Miguelmoral/ESP8266-energy-monitor/README.md

# ESP8266-energy-monitor

## Flashear firmware en la placa NodeMCU
Utilizar arduino IDE añadiendo la placa ESP8266 agregando en el gestor de URLs adicionales de tarjetas la [URL](http://arduino.esp8266.com/stable/package_esp8266com_index.json) 

## Aprovisionamiento servidor

- Descargar los archivos del repositorio:

 ` sudo git clone https://github.com/Miguelmoral/ESP8266-energy-monitor`

- Instalar requirements:

 ` cd ESP8266-energy-monitor `

  `sudo make install `

## Iniciar aplicación web

` make ejecutar `
