Miguelmoral/ESP8266-energy-monitor/documentación/portada/portada.tex

\begin{titlepage}

\newlength{\centeroffset}
\setlength{\centeroffset}{-0.5\oddsidemargin}
\addtolength{\centeroffset}{0.5\evensidemargin}
\thispagestyle{empty}

\noindent\hspace*{\centeroffset}\begin{minipage}{\textwidth}

\centering
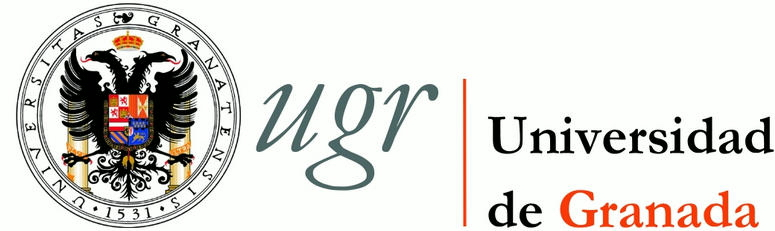
[picture p18: documentación/imagenes/logo_ugr.jpg]
\\[1.4cm]

\textsc{ \Large TRABAJO FIN DE GRADO\\[0.2cm]}
\textsc{ INGENIERÍA INFORMÁTICA}\\[1cm]
% Upper part of the page
% 
% Title
{\bfseries \LARGE Diseño e implementación de un sistema de monitorización de consumo eléctrico doméstico inalámbrico y libre.\\
}
\noindent\rule[-1ex]{\textwidth}{3pt}\\[3.5ex]
{\large\bfseries}
\end{minipage}

\vspace{2.5cm}
\noindent\hspace*{\centeroffset}\begin{minipage}{\textwidth}
\centering

\textbf{Autor}\\ {Miguel Moral Llamas}\\[2.5ex]
\textbf{Tutor}\\
{Sergio Alonso Burgos
}\\[2cm]
\\[0.1cm]
\textsc{Escuela Técnica Superior de Ingenierías Informática y de Telecomunicación}\\
\textsc{---}\\
Granada, junio de 2017
\end{minipage}
%\addtolength{\textwidth}{\centeroffset}
%\vspace{\stretch{2}}
\end{titlepage}
