Miguelmoral/ESP8266-energy-monitor/documentación/portada/portada_2.tex

\begin{titlepage}

\setlength{\centeroffset}{-0.5\oddsidemargin}
\addtolength{\centeroffset}{0.5\evensidemargin}
\thispagestyle{empty}

\noindent\hspace*{\centeroffset}\begin{minipage}{\textwidth}

\centering
%\includegraphics[width=0.9\textwidth]{imagenes/logo_ugr.jpg}\\[1.4cm]

%\textsc{ \Large PROYECTO FIN DE CARRERA\\[0.2cm]}
%\textsc{ INGENIERÍA EN INFORMÁTICA}\\[1cm]
% Upper part of the page
% 

 \vspace{3.3cm}

%si el proyecto tiene logo poner aquí
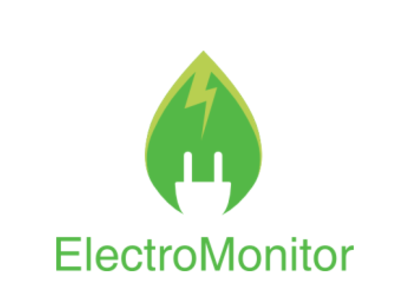
[picture p19: documentación/imagenes/logo.png]
 
 \vspace{0.5cm}

% Title

{\Huge\bfseries Diseño e implementación de un sistema de monitorización de consumo eléctrico doméstico inalámbrico y libre.\\
}
\noindent\rule[-1ex]{\textwidth}{3pt}\\[3.5ex]
%{\large\bfseries Subtítulo del proyecto.\\[4cm]}
\end{minipage}

\vspace{2.5cm}
\noindent\hspace*{\centeroffset}\begin{minipage}{\textwidth}
\centering

\textbf{Autor}\\ {Miguel Moral Llamas}\\[2.5ex]
\textbf{Tutor}\\
{Sergio Alonso Burgos}\\[2cm]
%\includegraphics[width=0.15\textwidth]{imagenes/tstc.png}\\[0.1cm]
%\textsc{Departamento de Teoría de la Señal, Telemática y Comunicaciones}\\
%\textsc{---}\\
%Granada, mes de 201
\end{minipage}
%\addtolength{\textwidth}{\centeroffset}
\vspace{\stretch{2}}

\end{titlepage}
