Miguelmoral/ESP8266-energy-monitor/documentación/proyecto.tex

\documentclass[a4paper,11pt]{book}
%\documentclass[a4paper,twoside,11pt,titlepage]{book}
\usepackage{listings}
\usepackage[utf8]{inputenc}
\usepackage[spanish]{babel}
\usepackage{float}
\usepackage{tikz}
\def\checkmark{\tikz\fill[scale=0.4](0,.35) -- (.25,0) -- (1,.7) -- (.25,.15) -- cycle;}
\usepackage{lscape}
\usepackage{eurosym}
\usepackage{appendix}
\usepackage{multirow}
\usepackage{graphicx }
\newcommand{\tabitem}{~~\llap{\textbullet}~~}
\usepackage{makecell}

% \usepackage[style=list, number=none]{glossary} %
%\usepackage{titlesec}
%\usepackage{pailatino}

\decimalpoint
\usepackage{dcolumn}
\newcolumntype{.}{D{.}{\esperiod}{-1}}
\makeatletter
\addto\shorthandsspanish{\let\esperiod\es@period@code}
\makeatother

%\usepackage[chapter]{algorithm}
\RequirePackage{verbatim}
%\RequirePackage[Glenn]{fncychap}
\usepackage{fancyhdr}
\usepackage{graphicx}
\usepackage{afterpage}

\usepackage{longtable}

\usepackage[pdfborder={000}]{hyperref} %referencia

% ********************************************************************
% Re-usable information
% ********************************************************************
\newcommand{\myTitle}{Monitorización del consumo eléctrico inalámbrico libre\xspace}
\newcommand{\myDegree}{Grado en informática\xspace}
\newcommand{\myName}{Miguel Moral Llamas\xspace}
\newcommand{\myProf}{Sergio Alonso Burgos\xspace}
%\newcommand{\mySupervisor}{Put name here\xspace}
\newcommand{\myFaculty}{Escuela Técnica Superior de Ingenierías Informática y de
Telecomunicación\xspace}
\newcommand{\myFacultyShort}{E.T.S. de Ingenierías Informática y de
Telecomunicación\xspace}
\newcommand{\myDepartment}{Departamento de ...\xspace}
\newcommand{\myUni}{\protect{Universidad de Granada}\xspace}
\newcommand{\myLocation}{Granada\xspace}
\newcommand{\myTime}{\today\xspace}
\newcommand{\myVersion}{Version 0.1\xspace}

\hypersetup{
pdfauthor = {\myName (email (en) ugr (punto) es)},
pdftitle = {\myTitle},
pdfsubject = {},
pdfkeywords = {palabra_clave1, palabra_clave2, palabra_clave3, ...},
pdfcreator = {LaTeX con el paquete ....},
pdfproducer = {pdflatex}
}

%\hyphenation{}

%\usepackage{doxygen/doxygen}
%\usepackage{pdfpages}
\usepackage{url}
\usepackage{colortbl,longtable}
\usepackage[stable]{footmisc}
%\usepackage{index}

%\makeindex
%\usepackage[style=long, cols=2,border=plain,toc=true,number=none]{glossary}
% \makeglossary

% Definición de comandos que me son tiles:
%\renewcommand{\indexname}{Índice alfabético}
%\renewcommand{\glossaryname}{Glosario}

\pagestyle{fancy}
\fancyhf{}
\fancyhead[LO]{\leftmark}
\fancyhead[RE]{\rightmark}
\fancyhead[RO,LE]{\textbf{\thepage}}
\renewcommand{\chaptermark}[1]{\markboth{\textbf{#1}}{}}
\renewcommand{\sectionmark}[1]{\markright{\textbf{\thesection. #1}}}

\setlength{\headheight}{1.5\headheight}

\newcommand{\HRule}{\rule{\linewidth}{0.5mm}}
%Definimos los tipos teorema, ejemplo y definición podremos usar estos tipos
%simplemente poniendo \begin{teorema} \end{teorema} ...
\newtheorem{teorema}{Teorema}[chapter]
\newtheorem{ejemplo}{Ejemplo}[chapter]
\newtheorem{definicion}{Definición}[chapter]

\definecolor{gray97}{gray}{.97}
\definecolor{gray75}{gray}{.75}
\definecolor{gray45}{gray}{.45}
\definecolor{gray30}{gray}{.94}

\lstset{ frame=Ltb,
     framerule=0.5pt,
     aboveskip=0.5cm,
     framextopmargin=3pt,
     framexbottommargin=3pt,
     framexleftmargin=0.1cm,
     framesep=0pt,
     rulesep=.4pt,
     backgroundcolor=\color{gray97},
     rulesepcolor=\color{black},
     %
     stringstyle=\ttfamily,
     showstringspaces = false,
     basicstyle=\scriptsize\ttfamily,
     commentstyle=\color{gray45},
     keywordstyle=\bfseries,
     %
     numbers=left,
     numbersep=6pt,
     numberstyle=\tiny,
     numberfirstline = false,
     breaklines=true,
   }
 
% minimizar fragmentado de listados
\lstnewenvironment{listing}[1][]
   {\lstset{#1}\pagebreak[0]}{\pagebreak[0]}

\lstdefinestyle{CodigoC}
   {
	basicstyle=\scriptsize,
	frame=single,
	language=C,
	numbers=left
   }
\lstdefinestyle{CodigoC++}
   {
	basicstyle=\small,
	frame=single,
	backgroundcolor=\color{gray30},
	language=C++,
	numbers=left
   }

\lstdefinestyle{Consola}
   {basicstyle=\scriptsize\bf\ttfamily,
    backgroundcolor=\color{gray30},
    frame=single,
    numbers=none
   }

\newcommand{\bigrule}{\titlerule[0.5mm]}

%Para conseguir que en las páginas en blanco no ponga cabecerass
\makeatletter
\def\clearpage{%
  \ifvmode
    \ifnum \@dbltopnum =\m@ne
      \ifdim \pagetotal <\topskip
        \hbox{}
      \fi
    \fi
  \fi
  \newpage
  \thispagestyle{empty}
  \write\m@ne{}
  \vbox{}
  \penalty -\@Mi
}
\makeatother

\usepackage{pdfpages}
\begin{document}
\renewcommand{\listtablename}{Lista de Tablas}
\renewcommand{\tablename}{Tabla} 
\input{portada/portada}
\input{prefacios/prefacio}
%\frontmatter
\tableofcontents
\listoffigures
\listoftables
%
%\mainmatter
%\setlength{\parskip}{5pt}

\input{capitulos/01_Introduccion}
%
\input{capitulos/02_Objetivos}
%
\input{capitulos/03_Planificacion_y_presupuesto}
%
\input{capitulos/04_Modulo_hardware}
%
\input{capitulos/05_Modulo_firmware}
%
\input{capitulos/06_Parte_servidor}
%
\input{capitulos/07_Pruebas}
%
\input{capitulos/08_Experimentacion}
%
\input{capitulos/09_Conclusiones_y_trabajos_futuros}
%
\appendix
\input{apendices/Anexo}
%
%\input{capitulos/08_Conclusiones}
%
%%\chapter{Conclusiones_y_Trabajos Futuros}
%
%
%%\nocite{*}
\bibliography{bibliografia/bibliografia}\addcontentsline{toc}{chapter}{Bibliografía}
\bibliographystyle{plain}
%
%\appendix
%\input{apendices/manual_usuario/manual_usuario}
%%\input{apendices/paper/paper}
%\input{glosario/entradas_glosario}
% \addcontentsline{toc}{chapter}{Glosario}
% \printglossary
\chapter*{}
\thispagestyle{empty}

\end{document}
