Miguelmoral/ESP8266-energy-monitor/documentación/capitulos/01_Introduccion.pdf

# Cap´ıtulo 1

# Introducci´on

## 1.1. Contexto

A medida que va avanzando la tecnolog´ıa van apareciendo nuevos aparatos el´ectricos en nuestros hogares con el gasto el´ectrico que implica tener estos aparatos conectados a la electricidad. Si tenemos un control sobre el consumo el´ectrico que tenemos en casa en todo momento nos permitir´a recortar consumos innecesarios, reduciendo de esta forma la factura de luz. A d´ıa de hoy la mayor´ıa de hogares disponen de una conexi´on a internet, permitiendo de esta forma mandar los datos recogidos por el sensor a un servidor local de una manera c´omoda y sencilla. Cada vez m´as dispositivos cuentan con conexi´on a internet lo que permite que dispositivos que no imaginar´ıamos que se pudieran comunicar ya sea con otros dispositivos o con alg´un servidor como puede ser una lavadora, un frigor´ıgico,... tengan la capacidad de mandar o recibir datos.

1
