Miguelmoral/ESP8266-energy-monitor/documentación/imagenes/aprovisionamiento1.PNG

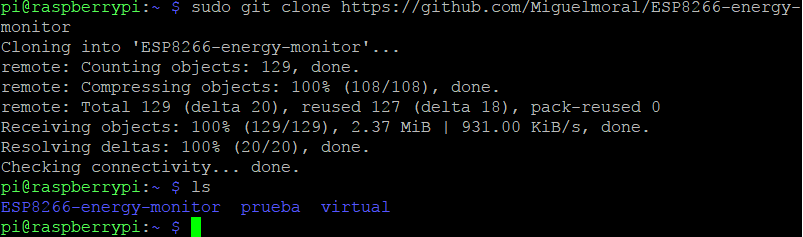
documentación/imagenes/aprovisionamiento1.PNG
