Miguelmoral/ESP8266-energy-monitor/documentación/imagenes/datoscongelador.PNG

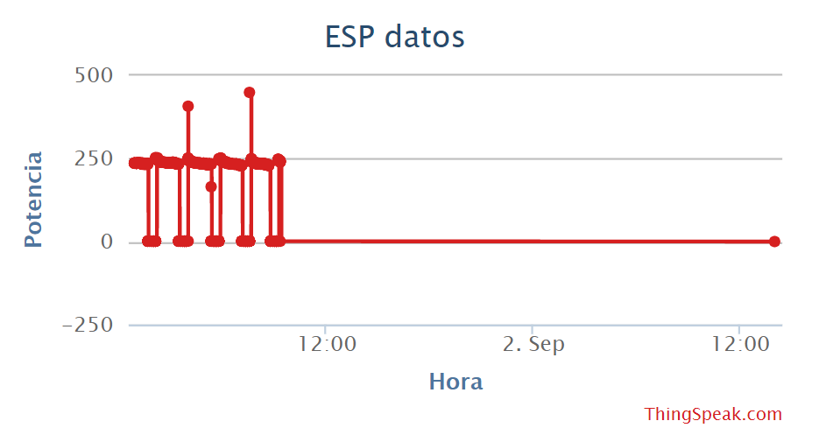
documentación/imagenes/datoscongelador.PNG
