Miguelmoral/ESP8266-energy-monitor/documentación/imagenes/detallegrafica.PNG

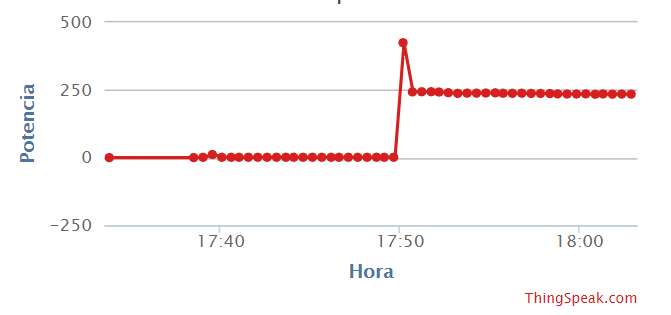
documentación/imagenes/detallegrafica.PNG
