Miguelmoral/ESP8266-energy-monitor/documentación/imagenes/Diagrama_Objetivos.png

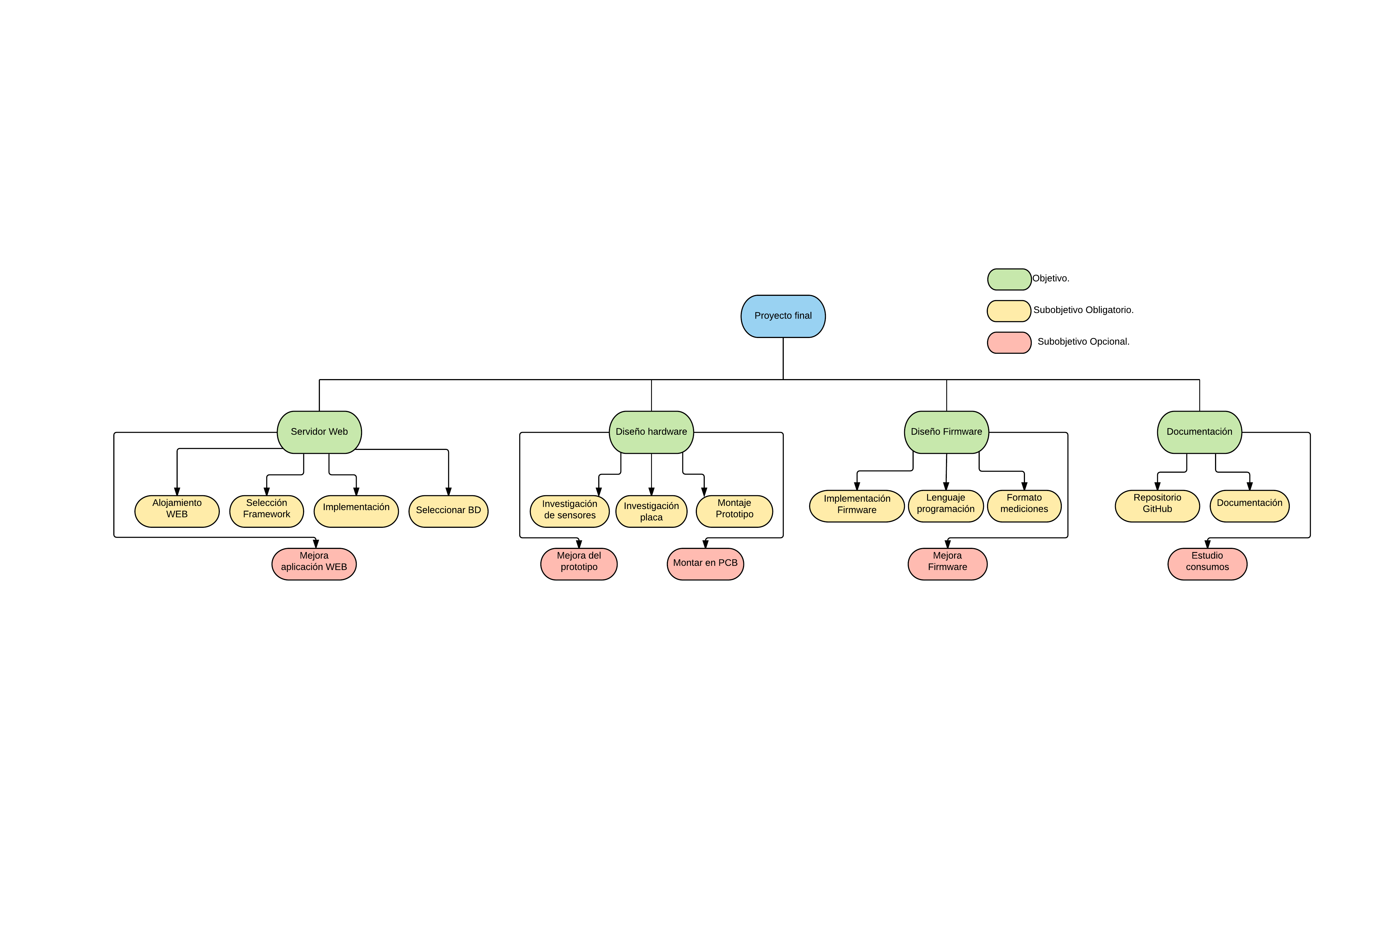
documentación/imagenes/Diagrama_Objetivos.png
