Miguelmoral/ESP8266-energy-monitor/documentación/imagenes/ohm.png

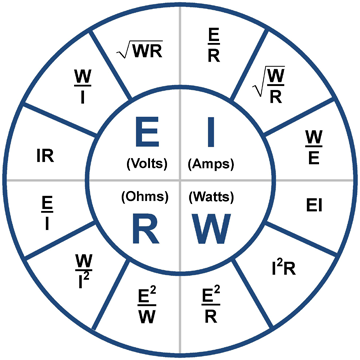
documentación/imagenes/ohm.png
