Miguelmoral/ESP8266-energy-monitor/documentación/imagenes/tablaondas.PNG

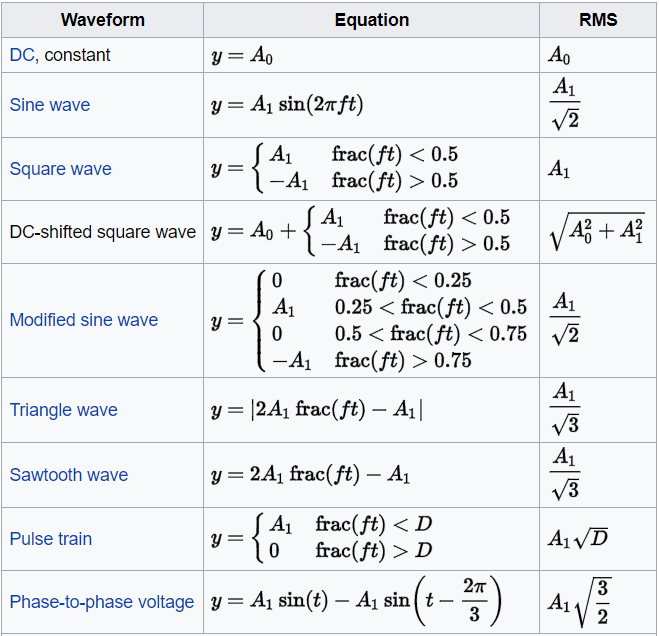
documentación/imagenes/tablaondas.PNG
